ederya/STM32-DevBoard/Doc/Schematics/Com.pdf

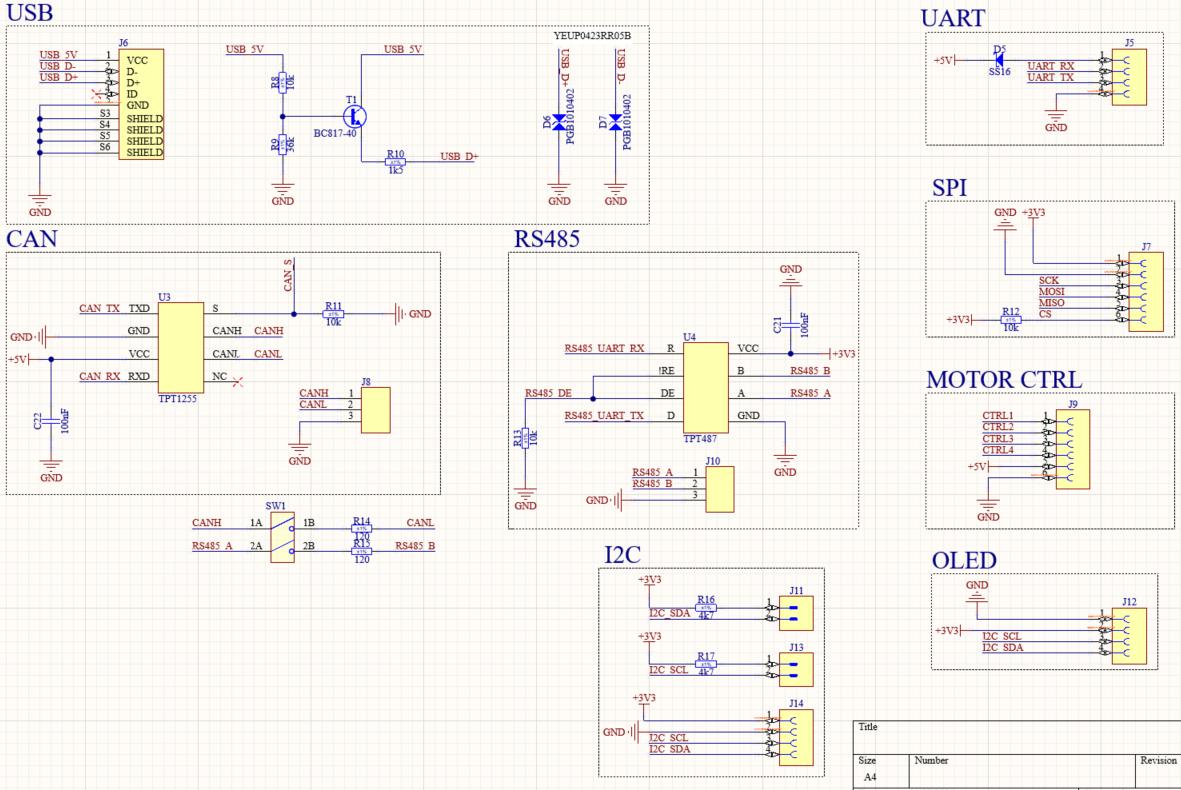
[picture p3: page 1]
