ederya/STM32-DevBoard/Doc/Schematics/Core.pdf

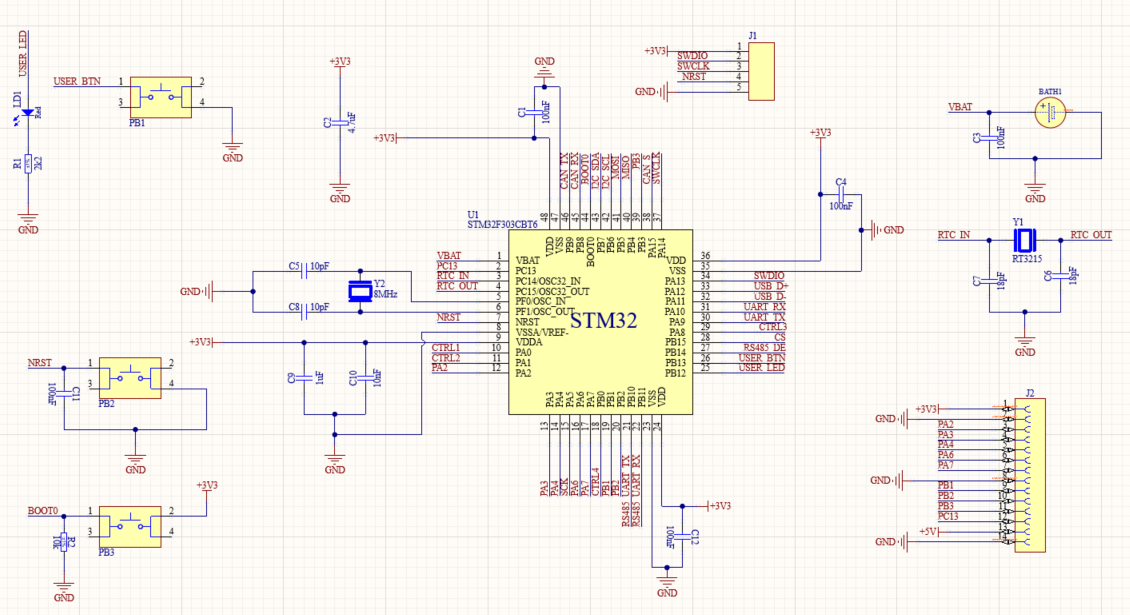
[picture p4: figure]
