ederya/STM32-DevBoard/Doc/Schematics/Power.pdf

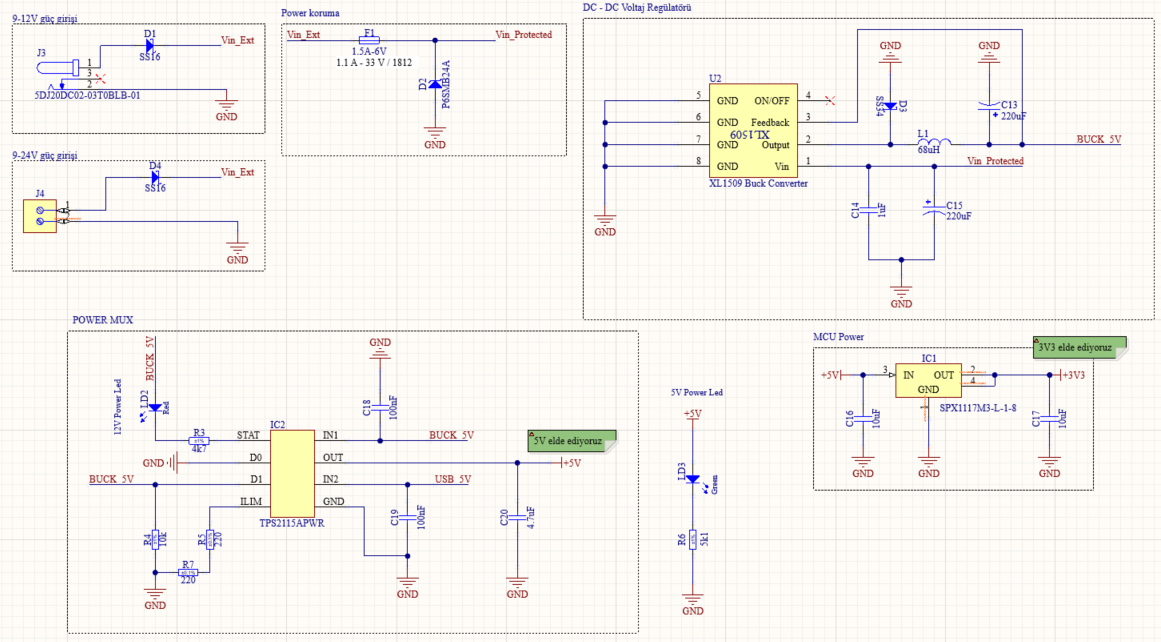
[picture p5: figure]
