ederya/STM32-DevBoard/Doc/Images/STM32_DevBoard.step

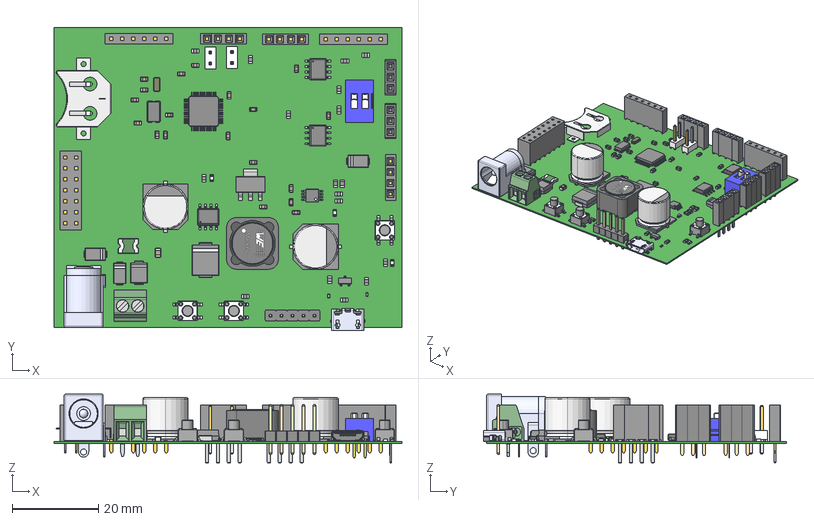
[picture p6: CAD file, 2026-11-02]
Doc/Images/STM32_DevBoard.step
80.6 x 70.2 x 15.9 mm
BATH_KEYSTONE_3000
PPPC021LFBN-RC_C03 x 2
Pin - Gold x 6
SOT95P230X110-3N
RESC1608X55N x 15
RESC1608X64N x 2
SWT0211 x 3
LED_KINGBRIGHT_KP-1608CGCK
LED_KINGBRIGHT_KP-1608
LED_KINGBRIGHT_KPH-1608SURCK_Part1 x 2
LED_KINGBRIGHT_KPH-1608SURCK_Part2 x 2
Core
ShieldRing
Glue
Leadframe
SAMTEC_SSW-104-02-L-S x 3
SAMTEC_HTSW-101-23-L-D x 2
SAMTEC_SSW-106-01-L-S x 2
10118192-0002LF_10118192-0002LF
PHOENIX_1751248
54-00166_insulator
54-00166_backplate
54-00166_center pin
54-00166_center terminal
54-00166_spring terminal
54-00166_switch terminal
SAMTEC_SSW-107-01-G-D
DS1021-1_5SF1-1
SOT230P700X180-4N
FUSRC4632X90N
LITTELFUSE_PGB1010402 x 2
DIOM5127X229N x 3
DIOM7959X265N
DIOM5436X261N
CAPC1608X87N x 15
CAPC1608X90N x 2
CAPC1608X80N x 2
CAPAE1030X1020N x 2
CAPC2012X110N
