ederya/STM32-DevBoard/(list of files, cad)

Other CAD files:
Doc/Images/STM32_DevBoard.stl
