ederya/STM32-DevBoard/(list of files, drawings)

Other design files:
Com.SchDoc
Core.SchDoc
Power.SchDoc
STM32 DevBoard.PrjPcb
STM32.PcbLib
STM32.SchLib
STM32_DevBoard.PcbDoc
