ederya/STM32-DevBoard/(commit log)

2026-10-04 Rebuild STM32 DevBoard project
    Recreated the Altium project structure and restored the schematic and library files.
    [Core.SchDoc, STM32 DevBoard.PrjPcb, STM32.PcbLib, STM32.SchLib]
2026-10-08 Add STM32 core circuitry and USB interface
    [Com.SchDoc, Core.SchDoc, Power.SchDoc, STM32 DevBoard.PrjPcb, STM32.PcbLib, STM32.SchLib]
2026-10-26 feat: complete STM32 dev board schematic design
    [Com.SchDoc, Core.SchDoc, Power.SchDoc, STM32.PcbLib, STM32.SchLib]
2026-11-02 feat: complete STM32 DevBoard hardware design
    - Finalize schematics and 2-layer PCB layout.
    - Update custom component libraries and organize datasheets.
    - Add schematic PDFs and 2D/3D PCB previews.
    - Add interactive Altium 365 viewer.
    - Document hardware specifications and engineering design decisions.
    [Com.SchDoc, Core.SchDoc, Power.SchDoc, STM32 DevBoard.PrjPcb, STM32.PcbLib, STM32.SchLib, STM32_DevBoard.PcbDoc, STM32_DevBoard.step]
